ziyingyang519/smart-vacuum-car/mechanical/lower_plate_lasercut.dxf

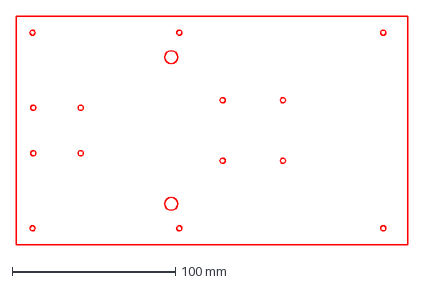
[picture p8: CAD file, 2026-11-09]
mechanical/lower_plate_lasercut.dxf
240.0 x 140.0 mm
