ziyingyang519/smart-vacuum-car/mechanical/upper_plate_lasercut.dxf

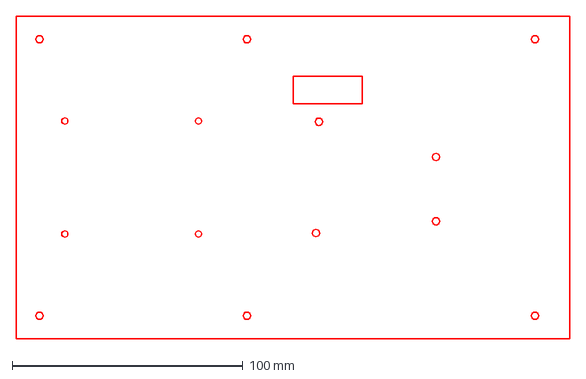
[picture p9: CAD file, 2026-11-09]
mechanical/upper_plate_lasercut.dxf
240.0 x 140.0 mm
